Knyllahsyhn/arducool/cool.kicad_sch

## KiCad design cool.kicad_sch (2026-08-02)

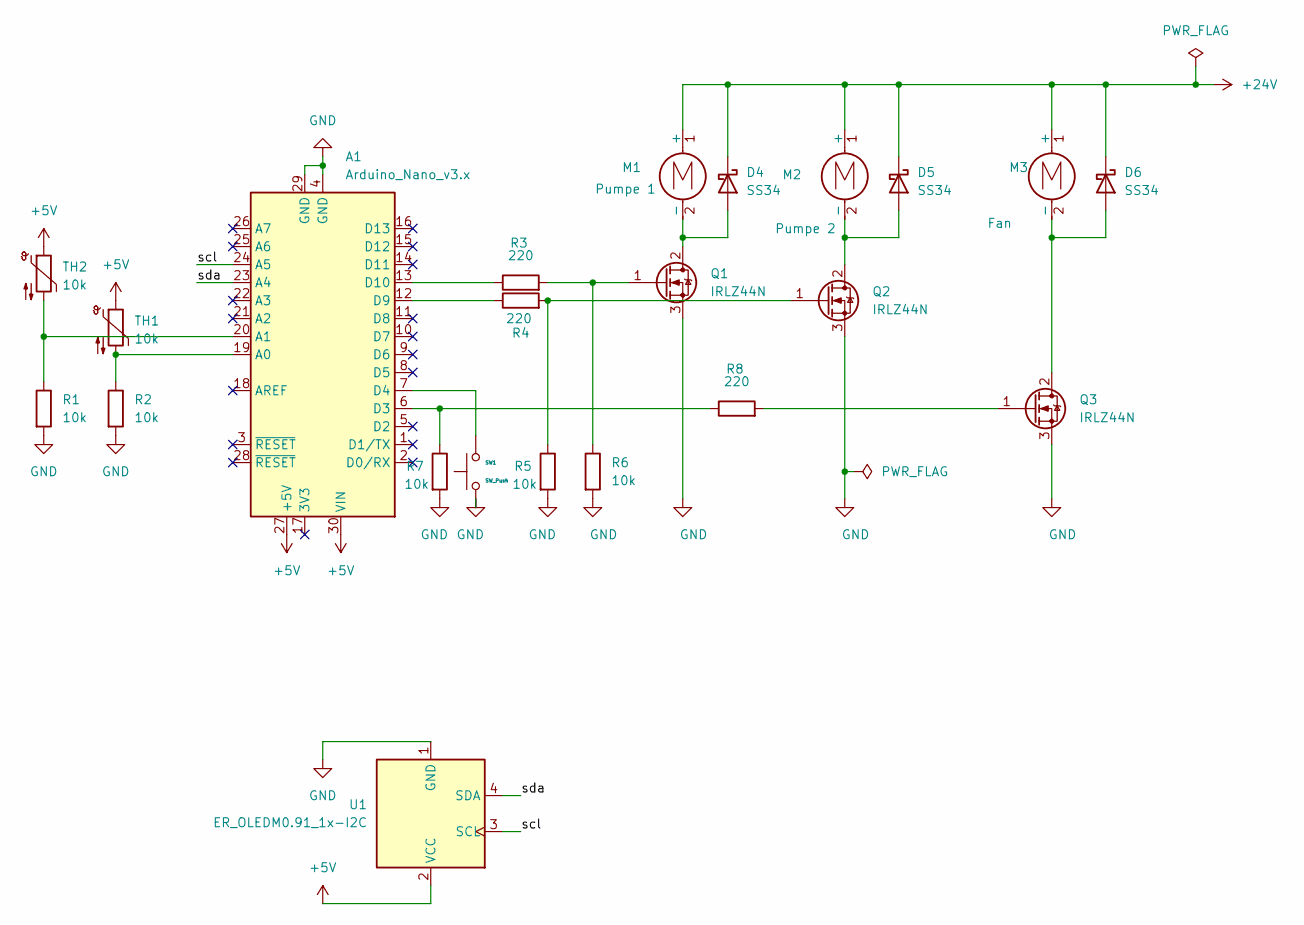
[picture p1: schematic cool.kicad_sch]

Parts:
A1: Arduino_Nano_v3.x; Arduino_Nano
D4, D5, D6: SS34; D_SMA
M1: Pumpe 1
M2: Pumpe 2
M3: Fan
Q1, Q2, Q3: IRLZ44N; TO-220-3_Vertical
R1, R2, R5, R6, R7: 10k
R3, R4, R8: 220
SW1: SW_Push
TH1, TH2: 10k
U1: ER_OLEDM0.91_1x-I2C

Connections:
+5V: A1.27 (+5V), A1.30 (VIN), TH1.1, TH2.1, U1.2 (VCC)
+24V: D4.1 (K), D5.1 (K), D6.1 (K), M1.1 (+), M2.1 (+), M3.1 (+)
GND: A1.4 (GND), A1.29 (GND), Q1.3 (S), Q2.3 (S), Q3.3 (S), R1.2, R2.2, R5.2, R6.2, R7.2, SW1.1, U1.1 (GND)
unnamed: A1.6 (D3), R7.1, R8.1
unnamed: A1.7 (D4), SW1.2
unnamed: A1.12 (D9), R4.1
unnamed: A1.13 (D10), R3.1
unnamed: A1.19 (A0), R2.1, TH1.2
unnamed: A1.20 (A1), R1.1, TH2.2
unnamed: D4.2 (A), M1.2 (-), Q1.2 (D)
unnamed: D5.2 (A), M2.2 (-), Q2.2 (D)
unnamed: D6.2 (A), M3.2 (-), Q3.2 (D)
unnamed: Q1.1 (G), R3.2, R6.1
unnamed: Q2.1 (G), R4.2, R5.1
unnamed: Q3.1 (G), R8.2
scl: A1.24 (A5), U1.3 (SCL)
sda: A1.23 (A4), U1.4 (SDA)
