Knyllahsyhn/arducool/(commit log)

2025-04-03 moved to inheritance model to derive fan and pump classes passed curves and hysteresis into constructor
2025-04-03 Update and rename c-cpp.yml to Arduino.yml
2025-04-03 added I2CDisplay Output made SetOff Public
2025-04-10 fixed sensor for current schematic added back serial logging because why tf not
2025-04-10 adjusted PWM range to 0-100 from 0-255 for easier setting removed redundant R0 in Sensors provided hint in Sensors.cpp how to adjust formula for reverse Sensor setup
2025-04-14 updated code for 24V usage adjusted timers to 32kHz for better resolution
2025-04-25 reverted back to 12V control
